Kevin-Yu0/Wildfire-Detection-System/README.md

# Wildfire-Detection-System
This is the codebase for the Wildfire Detection System Project
Computer Engineering Senior Capstone 2025-2026
Contributors:
    Kevin Yu
    Manny Lemus
    Jake Gilbert
    Aliston Ma
    Frank Xiao
