Kevin-Yu0/Wildfire-Detection-System/FirePredictionModel/testing.csv

Temperature | Humidity | Pressure | CO | CO2 | Fire
28.2 | 48.1 | 1030.0 | 0.31 | 821.0 | False
27.3 | 47.9 | 1030.0 | 0.13 | 919.0 | False
27.0 | 48.5 | 1030.0 | 0.0 | 534.0 | False
26.3 | 51.7 | 1030.0 | 0.22 | 618.0 | False
28.2 | 48.2 | 1030.0 | 0.39 | 657.0 | False
27.7 | 48.4 | 1030.0 | 0.13 | 586.0 | False
27.0 | 49.5 | 1030.0 | 0.0 | 735.0 | False
25.9 | 51.6 | 1030.0 | 0.0 | 542.0 | False
28.2 | 46.8 | 1030.0 | 0.55 | 969.0 | False
26.8 | 48.4 | 1030.0 | 0.0 | 721.0 | False
27.3 | 47.6 | 1030.0 | 0.15 | 921.0 | False
27.0 | 48.5 | 1030.0 | 0.0 | 396.0 | False
26.3 | 50.9 | 1030.0 | 0.13 | 614.0 | False
28.3 | 48.1 | 1030.0 | 0.42 | 314.0 | False
27.7 | 48.0 | 1030.0 | 0.05 | 372.0 | False
27.0 | 49.3 | 1030.0 | 0.0 | 733.0 | False
25.9 | 51.6 | 1030.0 | 0.0 | 542.0 | False
28.3 | 46.5 | 1030.0 | 0.5 | 992.0 | False
26.8 | 48.5 | 1030.0 | 0.0 | 682.0 | False
27.4 | 47.8 | 1030.0 | 0.08 | 912.0 | False
27.1 | 48.4 | 1030.0 | 0.0 | 377.0 | False
26.3 | 51.5 | 1030.0 | 0.11 | 614.0 | False
28.3 | 48.1 | 1030.0 | 0.46 | 788.0 | False
27.7 | 48.1 | 1030.0 | 0.05 | 366.0 | False
27.0 | 49.4 | 1030.0 | 0.0 | 732.0 | False
25.9 | 51.6 | 1030.0 | 0.0 | 543.0 | False
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
