Kevin-Yu0/Wildfire-Detection-System/ProbabilisticModel/predicted_risks.txt

0.360746964422575
0.8069171975430744
0.8726691886779507
0.8071098625073059
0.7727003178172407
0.6741191261657935
0.6646968532397883
0.6806653188362497
0.6373035740692998
0.6263281465865955
0.6263246373152564
0.611810336344583
0.6550779927676633
0.6677758128224125
0.6498132174363003
0.6157009983086625
0.5565484368189784
0.508103074865732
0.48236776221442285
0.4208145826153193
0.3806885467212509
0.3787904225008291
0.37082365445959303
0.3448562925349122
0.2881940492527589
0.2852438747677704
0.2739318615012929
0.23260030142554783
0.15075195819317677
0.17754349137138148
0.7322764516737892
0.7241777614738303
0.7015395625030147
0.670561864579406
0.23409152323368082
0.23189100338947605
0.1971945344639729
0.6303944466140097
0.20161396106328533
0.19411786430916278
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
