Kevin-Yu0/Wildfire-Detection-System/PCB/WildfireDetectionSystem.brd

## EAGLE design PCB/WildfireDetectionSystem.brd (2026-04-28)

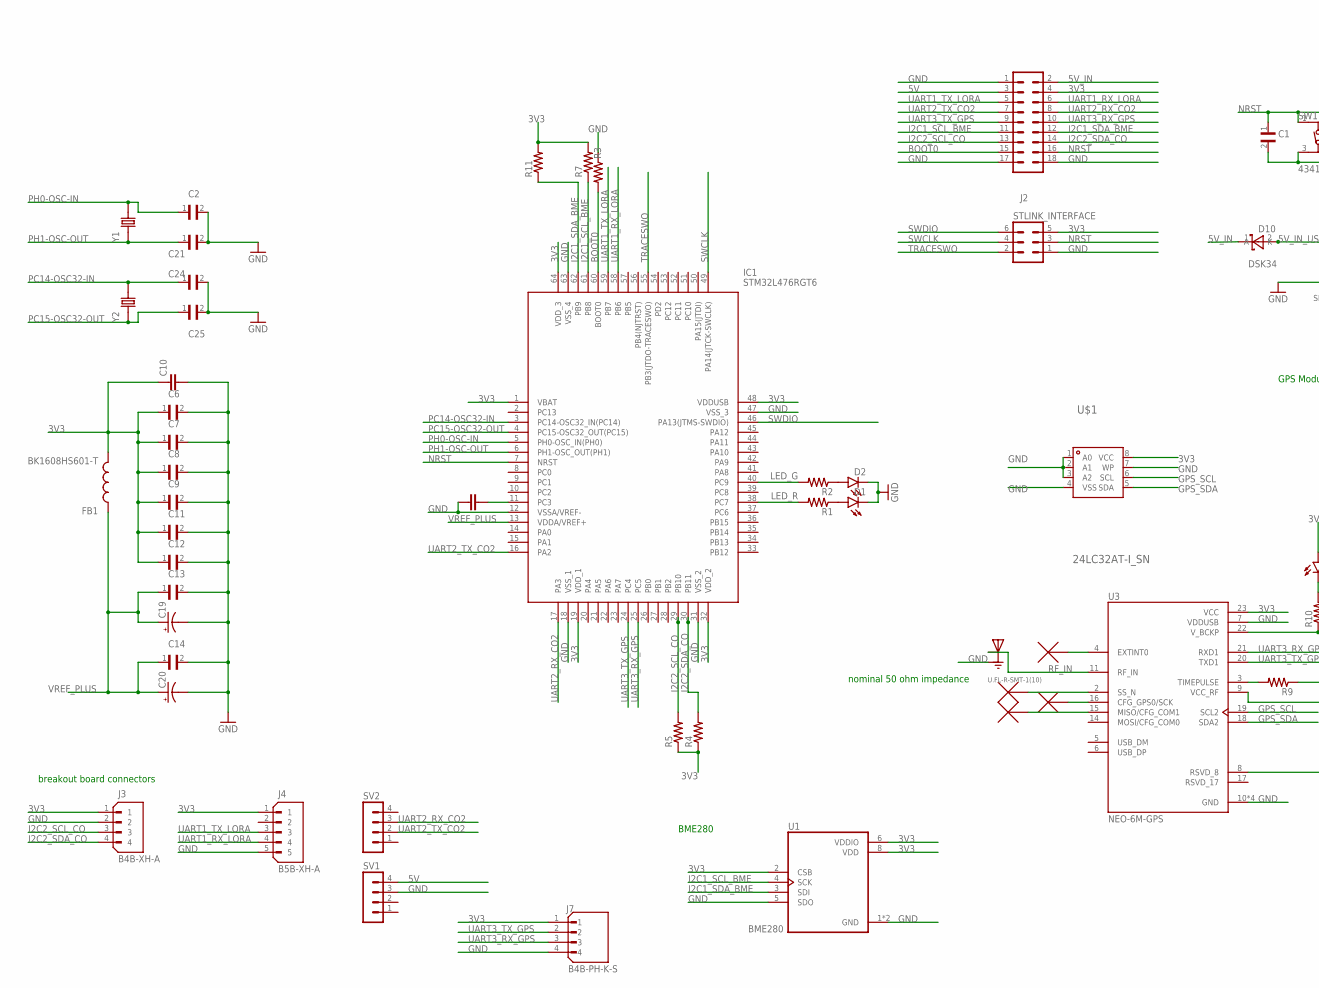
[picture p1: schematic WildfireDetectionSystem.sch, part in row 1, column 1]

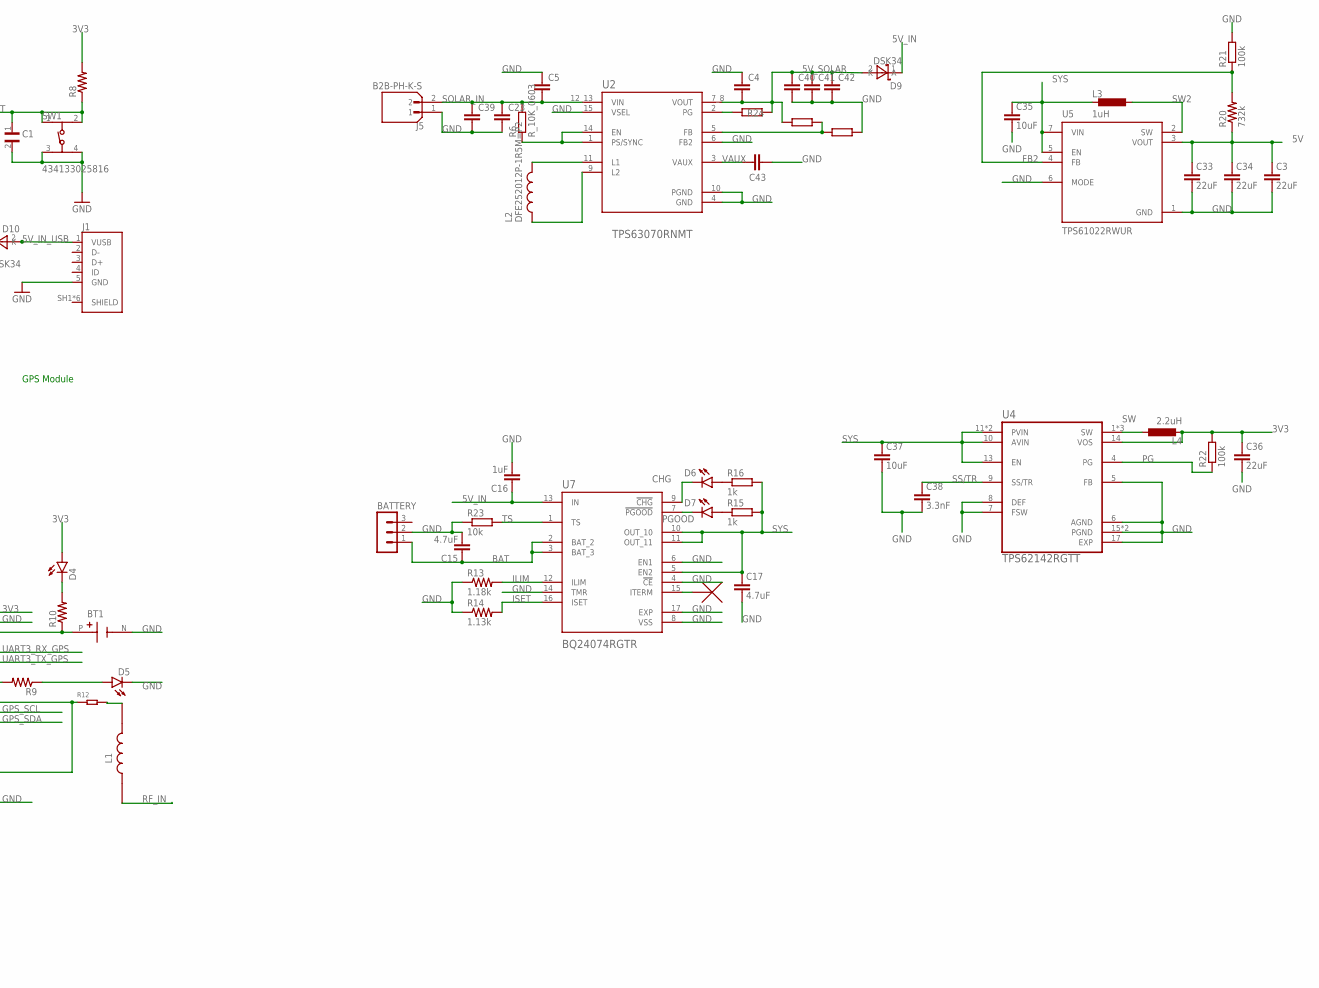
[picture p2: schematic WildfireDetectionSystem.sch, part in row 1, column 2]

Parts:
BATTERY: MA03-1
BT1: 1056TR; BAT_1056TR
C1, C6, C7, C8, C9, C11, C12, C13, C14: CL05B104KO5NNNC; CAPC1005X55N
C2, C21, C24, C25: CL10C200JB8NNNC; CAPC1608X90N
C3, C33, C34, C36: 22uF; C0603
C4, C5: C_10UF/10V_0603; C0603
C10, C22: CC0603KRX5R7BB105; CAPC1608X90
C15, C17: 4.7uF; C0603
C16: 1uF; C0603
C19, C20: TAJA105K016RNJ; CAPPM3216X180N
C23, C39: C_10UF/25V_0805; C0805
C35, C37: 10uF; C0603
C38: 3.3nF; C0603
C40, C41, C42: C_22UF/25V_0805; C0805
C43: C_100NF/50V_0603; C0603
D1, D2, D5, D6: SML-P12MTT86; LED_SML-P11UTT86R
D4, D7: SML-P12VTT86; LED_SML-P11UTT86R
D9, D10: DSK34; SOD-123_L2.8-W1.8-LS3.7-RD
FB1: BK1608HS601-T; BEADC1608X95N
IC1: STM32L476RGT6; QFP50P1200X1200X160-64N
J1: 10118192-0001LF; AMPHENOL_10118192-0001LF
J2: MA09-2
J3: B4B-XH-A; JST_B4B-XH-A
J4: B5B-XH-A; JST_B5B-XH-A
J5: B2B-PH-K-S; JST_B2B-PH-K-S
J7: B4B-PH-K-S; JST_B4B-PH-K-S
J8: U.FL-R-SMT-1(10); HRS_U.FL-R-SMT-1(10)
L1: MLZ2012P220WT000; INDC2012X145N
L2: DFE252012P-1R5M=P2; INDC2520X120N
L3: 1uH; R0805
L4: 2.2uH; R0805
R1, R2, R3, R4, R5, R9, R10: RC0402FR-071KL; RESC1005X40N
R6: R_10K_0603; R0603
R7, R11: RT0402FRE074K7L; RESC1005X35N
R8: RC0402FR-0710KL; RESC1005X40N
R12: SMD-RES-22R-1%-1/16W(0402); R0402
R13: 1.18k; R0603; LCSC_PART C861193
R14: 1.13k; R0603; LCSC_PART C137782
R15, R16: 1k; R0603
R20: 732k; R0603; LCSC_PART C403344
R21, R22: 100k; R0603
R23: 10k; R0603
R24: R_100K_0603; R0603
R25: R_680K_0603; R0603
R26: R_130K_0603; R0603
STLINK_INTERFACE: MA03-2
SV1, SV2: MA04-1
SW1: 434133025816
U1: BME280; PSON65P250X250X100-8N
U2: TPS63070RNMT; VREG_TPS63070RNMT
U3: NEO-6M-GPS; XCVR_NEO-6M-GPS
U4: TPS62142RGTT; QFN50P300X300X100-17N
U5: TPS61022RWUR; CONV_TPS61022RWUR
U7: BQ24074RGTR; QFN50P300X300X100-17N
U$1: 24LC32AT-I_SN; SOIC-8_L4.9-W3.9-P1.27-LS6.0-BL
Y1: ABLS-8.000MHZ-B2-T; XTAL_ABLS-8.000MHZ-B2-T
Y2: ECS-.327-12.5-12QS-TR; XTAL_ECS-.327-12.5-12QS-TR

Connections:
3V3: C6.1, C7.1, C8.1, C9.1, C10.1, C11.1, C12.1, C36.1, D4.A, FB1.2, IC1.1 (VBAT), IC1.19 (VDD_1), IC1.32 (VDD_2), IC1.48 (VDDUSB), IC1.64 (VDD_3), J2.4, J3.1, J4.1, J7.1, L4.2, R4.1, R5.1, R7.2, R8.2, R11.2, R22.2, STLINK_INTERFACE.5, U1.2 (CSB), U1.6 (VDDIO), U1.8 (VDD), U3.23 (VCC), U4.14 (VOS), U$1.8 (VCC)
5V: C3.1, C33.1, C34.1, J2.3, R20.1, SV1.4, U5.3 (VOUT)
5V_IN: C16.1, D9.1 (K), D10.1 (K), J2.2, U7.13 (IN)
5V_IN_USB: D10.2 (A), J1.1 (VUSB)
5V_SOLAR: C4.2, C40.1, C41.1, C42.1, D9.2 (A), R24.2, R25.1, U2.7_8 (VOUT)
BAT: BATTERY.1, C15.1, U7.2 (BAT_2), U7.3 (BAT_3)
BOOT0: IC1.60 (BOOT0), J2.15, R3.2
CHG: D6.C, U7.9 (!CHG)
FB2: R20.2, R21.1, U5.4 (FB)
GND: BATTERY.2, BT1.N (NEG), C1.2, C2.2, C3.2, C4.1, C5.1, C6.2, C7.2, C8.2, C9.2, C10.2, C11.2, C12.2, C13.2, C14.2, C15.2, C16.2, C17.2, C19.C (-), C20.C (-), C21.2, C22.1, C23.2, C24.2, C25.2, C33.2, C34.2, C35.2, C36.2, C37.2, C38.2, C39.2, C40.2, C41.2, C42.2, C43.2, D1.C, D2.C, D5.C, IC1.12 (VSSA/VREF-), IC1.18 (VSS_1), IC1.31 (VSS_2), IC1.47 (VSS_3), IC1.63 (VSS_4), J1.5 (GND), J2.1, J2.17, J2.18, J3.2, J4.5, J5.1, J7.4, J8.1 (GND), J8.3 (GND), R3.1, R13.1, R14.1, R21.2, R23.1, R26.1, STLINK_INTERFACE.1, SV1.3, SW1.3, SW1.4, U1.1 (GND), U1.5 (SDO), U1.7 (GND), U2.4 (GND), U2.6 (FB2), U2.10 (PGND), U2.15 (VSEL), U3.7 (VDDUSB), U3.10 (GND), U3.12 (GND), U3.13 (GND), U3.24 (GND), U4.5 (FB), U4.6 (AGND), U4.7 (FSW), U4.8 (DEF), U4.15 (PGND), U4.16 (PGND), U4.17 (EXP), U5.1 (GND), U5.6 (MODE), U7.4 (!CE), U7.6 (EN1), U7.8 (VSS), U7.14 (TMR), U7.17 (EXP), U$1.1 (A0), U$1.2 (A1), U$1.3 (A2), U$1.4 (VSS), U$1.7 (WP)
GPS_SCL: U3.19 (SCL2), U$1.6 (SCL)
GPS_SDA: U3.18 (SDA2), U$1.5 (SDA)
I2C1_SCL_BME: IC1.61 (PB8), J2.11, R7.1, U1.4 (SCK)
I2C1_SDA_BME: IC1.62 (PB9), J2.12, R11.1, U1.3 (SDI)
I2C2_SCL_CO: IC1.29 (PB10), J2.13, J3.3, R5.2
I2C2_SDA_CO: IC1.30 (PB11), J2.14, J3.4, R4.2
ILIM: R13.2, U7.12 (ILIM)
ISET: R14.2, U7.16 (ISET)
LED_G: IC1.40 (PC9), R2.2
LED_R: IC1.38 (PC7), R1.2
unnamed: D1.A, R1.1
unnamed: R9.2, U3.3 (TIMEPULSE)
unnamed: D2.A, R2.1
unnamed: C22.2, IC1.11 (PC3)
unnamed: D4.C, R10.2
unnamed: R12.1, U3.8 (RSVD_8), U3.9 (VCC_RF)
unnamed: L1.2, R12.2
unnamed: BT1.P (POS), R10.1, U3.22 (V_BCKP)
unnamed: D5.A, R9.1
unnamed: D6.A, R16.1
unnamed: D7.A, R15.1
unnamed: L2.2, U2.11 (L1)
unnamed: L2.1, U2.9 (L2)
unnamed: R6.1, U2.1 (PS/SYNC), U2.14 (EN)
unnamed: R24.1, U2.2 (PG)
unnamed: R25.2, R26.2, U2.5 (FB)
NRST: C1.1, IC1.7 (NRST), J2.16, R8.1, STLINK_INTERFACE.3, SW1.1, SW1.2
PC14-OSC32-IN: C24.1, IC1.3 (PC14-OSC32_IN(PC14)), Y2.2
PC15-OSC32-OUT: C25.1, IC1.4 (PC15-OSC32_OUT(PC15)), Y2.1
PG: R22.1, U4.4 (PG)
PGOOD: D7.C, U7.7 (!PGOOD)
PH0-OSC-IN: C2.1, IC1.5 (PH0-OSC_IN(PH0)), Y1.2
PH1-OSC-OUT: C21.1, IC1.6 (PH1-OSC_OUT(PH1)), Y1.1
RF_IN: J8.2 (SIG), L1.1, U3.11 (RF_IN)
SOLAR_IN: C5.2, C23.1, C39.1, J5.2, R6.2, U2.12_13 (VIN)
SS/TR: C38.1, U4.9 (SS/TR)
SW: L4.1, U4.1 (SW), U4.2 (SW), U4.3 (SW)
SW2: L3.1, U5.2 (SW)
SWCLK: IC1.49 (PA14(JTCK-SWCLK)), STLINK_INTERFACE.4
SWDIO: IC1.46 (PA13(JTMS-SWDIO)), STLINK_INTERFACE.6
SYS: C17.1, C35.1, C37.1, L3.2, R15.2, R16.2, U4.10 (AVIN), U4.11 (PVIN), U4.12 (PVIN), U4.13 (EN), U5.5 (EN), U5.7 (VIN), U7.5 (EN2), U7.10 (OUT_10), U7.11 (OUT_11)
TRACESWO: IC1.55 (PB3(JTDO-TRACESWO)), STLINK_INTERFACE.2
TS: R23.2, U7.1 (TS)
UART1_RX_LORA: IC1.58 (PB6), J2.6, J4.4
UART1_TX_LORA: IC1.59 (PB7), J2.5, J4.3
UART2_RX_CO2: IC1.17 (PA3), J2.8, SV2.3
UART2_TX_CO2: IC1.16 (PA2), J2.7, SV2.2
UART3_RX_GPS: IC1.25 (PC5), J2.10, J7.3, U3.21 (RXD1)
UART3_TX_GPS: IC1.24 (PC4), J2.9, J7.2, U3.20 (TXD1)
VAUX: C43.1, U2.3 (VAUX)
VREF_PLUS: C13.1, C14.1, C19.A (+), C20.A (+), FB1.1, IC1.13 (VDDA/VREF+)

Notes on the sheet:
breakout board connectors
GPS Module
BME280
nominal 50 ohm impedance

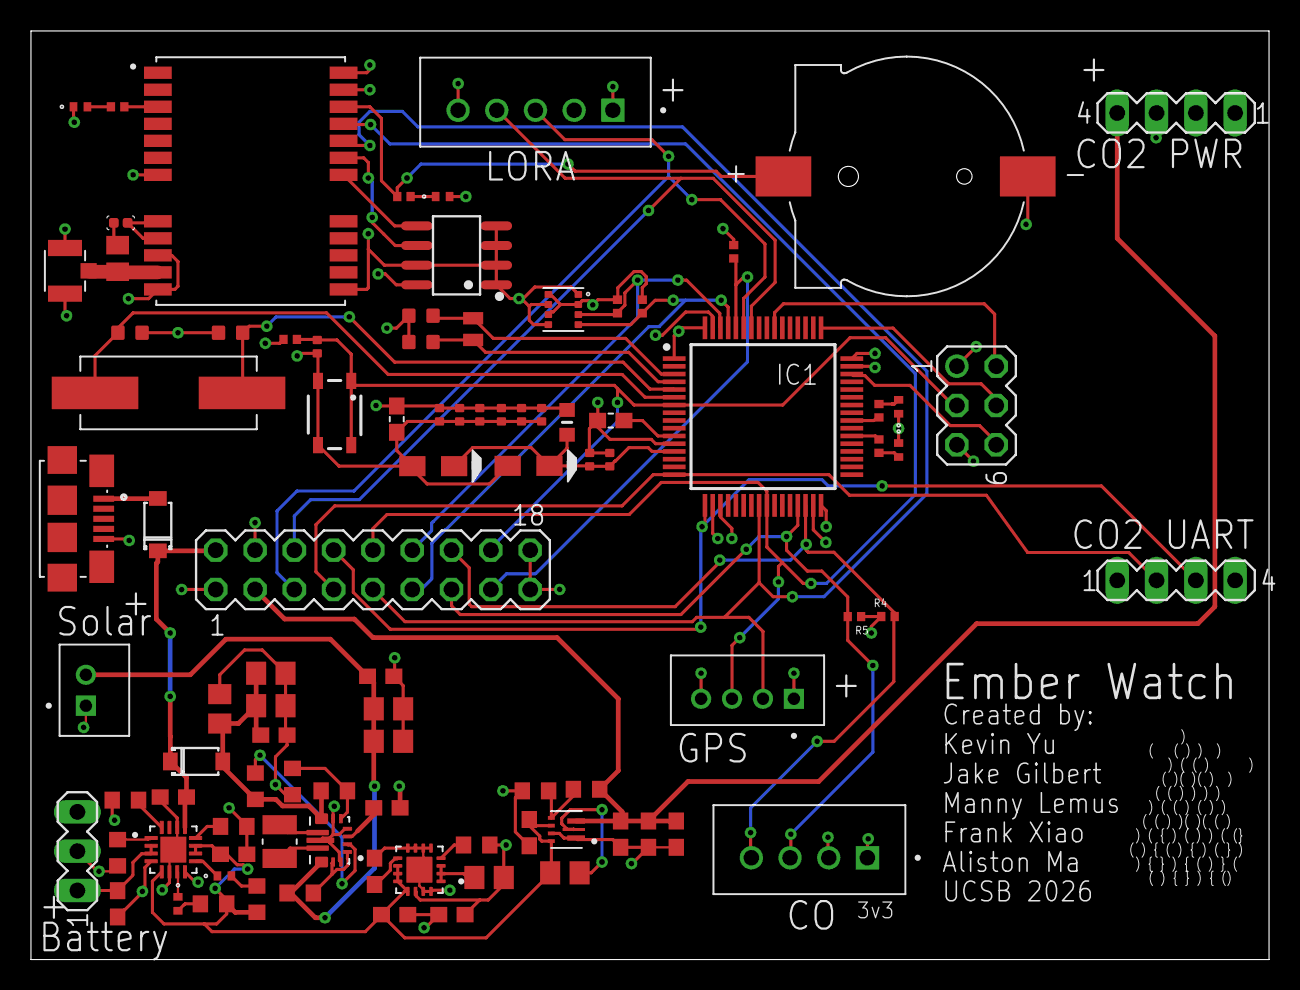
[picture p3: board WildfireDetectionSystem.brd from above]

Board: 4 copper layers, 80.0 x 60.0 mm, 94 parts (0 on the bottom side), 61 nets.
