Kevin-Yu0/Wildfire-Detection-System/L476_Node/Core/Src/gpio.c

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

/* Includes ------------------------------------------------------------------*/
#include "gpio.h"

/*----------------------------------------------------------------------------*/
/* Configure GPIO                                                             */
/*----------------------------------------------------------------------------*/
/** Configure pins
*/
void MX_GPIO_Init(void)
{
  GPIO_InitTypeDef GPIO_InitStruct = {0};

  /* GPIO Ports Clock Enable */
  __HAL_RCC_GPIOA_CLK_ENABLE();
  __HAL_RCC_GPIOC_CLK_ENABLE();
  __HAL_RCC_GPIOB_CLK_ENABLE();

  /* Set default output levels */
  HAL_GPIO_WritePin(GPIOB, GPIO_PIN_13, GPIO_PIN_RESET); /* S88 DIR = RX */
  HAL_GPIO_WritePin(GPIOC, GPIO_PIN_7 | GPIO_PIN_9, GPIO_PIN_RESET); /* LEDs off */

  /* PB13 — S88 RS-485 direction control */
  GPIO_InitStruct.Pin   = GPIO_PIN_13;
  GPIO_InitStruct.Mode  = GPIO_MODE_OUTPUT_PP;
  GPIO_InitStruct.Pull  = GPIO_NOPULL;
  GPIO_InitStruct.Speed = GPIO_SPEED_FREQ_LOW;
  HAL_GPIO_Init(GPIOB, &GPIO_InitStruct);

  /* PC7 — LED_R, PC9 — LED_G */
  GPIO_InitStruct.Pin   = GPIO_PIN_7 | GPIO_PIN_9;
  GPIO_InitStruct.Mode  = GPIO_MODE_OUTPUT_PP;
  GPIO_InitStruct.Pull  = GPIO_NOPULL;
  GPIO_InitStruct.Speed = GPIO_SPEED_FREQ_LOW;
  HAL_GPIO_Init(GPIOC, &GPIO_InitStruct);
}
