Kevin-Yu0/Wildfire-Detection-System/(commit log)

2026-01-22 LoRa to Supabase
    This is the bridge between the LoRa receiver and Supabase.
    this script is a base station bridge that sits between two totally different interfaces: on one side it has a serial (UART) stream coming from the RYLR998 LoRa receiver (connected to laptop through RYLS135 USB UART adapter) & on the other side it has an HTTPS REST client that talks to Supabase. Its entire job is to run forever and repeatedly do this pipeline: read one LoRa receive line → extract the CSV payload → convert it into a Python dict whose keys match your Supabase columns → POST that dict to Supabase.
2026-01-27 Created folderstructure and pushed PCB schematic and Board
    [WildfireDetectionSystem.brd, WildfireDetectionSystem.sch]
2026-01-28 edited board layout with comments from Kriteen
    [WildfireDetectionSystem.brd]
2026-01-29 clearance set to .1mm
    [WildfireDetectionSystem.brd]
2026-01-29 Frank's models
    [testing.csv, training.csv]
2026-02-05 Add LoRa → Supabase base station bridge with checksum validation and argparse support + a few minor changes, check script comments
2026-02-11 Replaced parts on PCB for JLC
2026-02-11 board and schematic changes
    [WildfireDetectionSystem.brd, WildfireDetectionSystem.sch]
2026-02-12 probabilistic model
    [model_comparison_results.csv]
2026-04-10 pcb v2
    [WildfireDetectionSystem.brd, WildfireDetectionSystem.sch]
2026-04-23 changed charging circuit to add buck/boost
    [WildfireDetectionSystem.brd, WildfireDetectionSystem.sch]
2026-04-23 inductor change
    [WildfireDetectionSystem.brd, WildfireDetectionSystem.sch, WildfireDetectionSystemBOM.csv]
2026-04-24 data log
    [data_log.csv]
2026-04-30 Frank's new model
    [data_log.csv, data_log_cleaned.csv, data_log_cleaned_labeled.csv]
2026-05-01 Predict Fire risk of data inside Supabase
    [supabase_fire_predictions.csv]
2026-05-08 Revised Model by Frank
    [5ft.csv, close.csv, cntrl.csv, processed_data.csv, processed_data_labeled.csv, supabase_fire_predictions_filtered.csv]
2026-05-10 ML: added STM32 L476 node project and firmware
2026-05-10 Update uart_recieve.py
    I literally only changed the comment on Line 2 from "hub_receiver.py" to "uart_recieve.py" to match the file name
2026-05-11 Update L476 node BME280 and CO sensor support
2026-05-11 Add LoRa RF power setup command
2026-05-23 Add mesh node STM32 project
2026-05-25 Delete FinalNode_mesh/EmberWatch_mesh directory
    no longer needed
    [main.c]
2026-05-28 Final version of training code
    [supabase_fire_predictions_all.csv]
