Kevin-Yu0/Wildfire-Detection-System/(notices)

Notices in the files:
L476_Node/Core/Src/gpio.c:
Copyright (c) 2025 STMicroelectronics.
All rights reserved.
This software is licensed under terms that can be found in the LICENSE file
